h-xh-git/STM32-ESP32-MP3-Player/docs/images/esp32s3-pinout.png

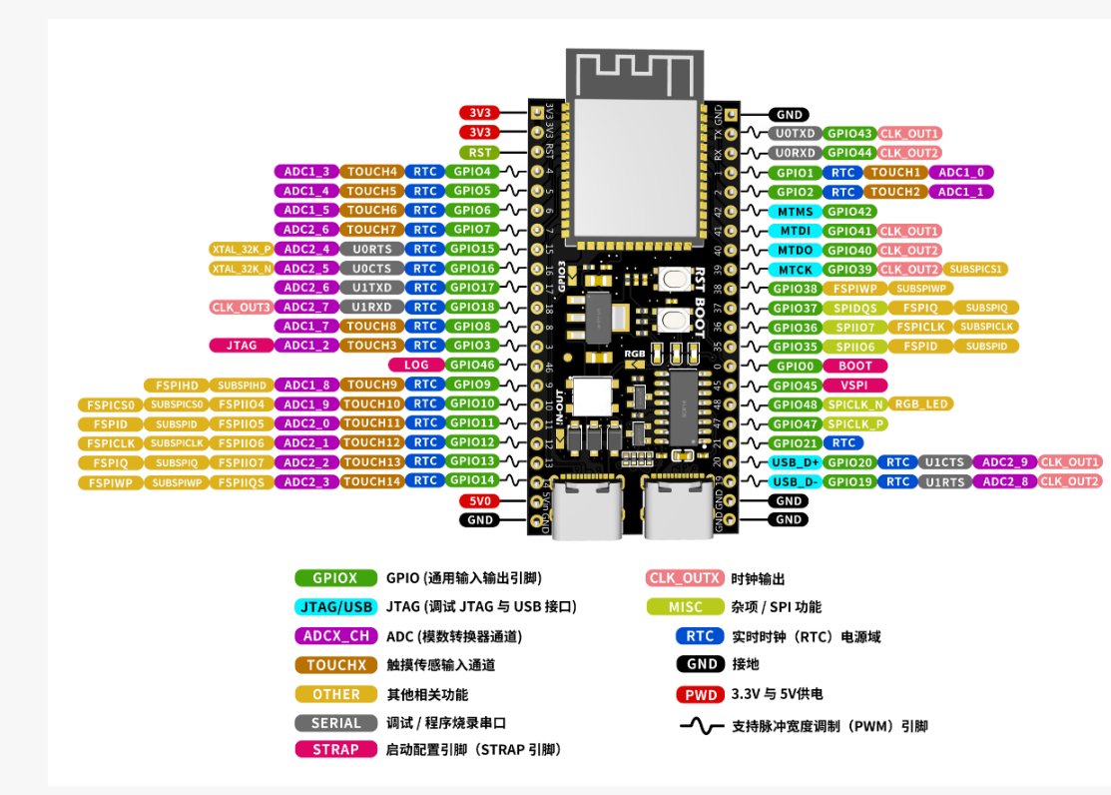
docs/images/esp32s3-pinout.png
