h-xh-git/STM32-ESP32-MP3-Player/docs/roadmap.md

# 基于 STM32F407 与 ESP32-S3 的双板 MP3 音乐播放器
# 最优项目开发规划书 (v2.0)

> **历史文档提示**：本文是开发初期的规划书，保留原样以记录当时的决策过程。
> 最终实现与验收以仓库根 [README.md](../README.md) 与 [docs/delivery-notes.md](delivery-notes.md) 为准 ——
> 例如 FatFS 码页最终采用 **437**（文中写的 936 是最初方案，为省 174 KB 转换表而改），GBK 歌词改由 `stm32/app/gbk2312_map.h` 提供。

> 编制依据：《基于STM32F407与ESP32-S3的双板MP3音乐播放器项目计划书》
> 补充依据：现有两套工程（STM32F407_ProjectTemplate 双板示波器 / esp32 WiFi Web Scope）代码勘察
> 硬件依据：立创天空星(LCKFB)官方 Wiki、ESP32-S3-WROOM-1 N16R8 引脚约束、MAX98357A 数据手册
> 版本说明：本版**完全放弃旧示波器工程的引脚约束**，按"最优"原则重新设计全部引脚。

---

## 0. 执行摘要

本规划书在四项前提已确认的基础上编制：

| 项目 | 已确认结论 |
|---|---|
| 硬件形态 | 立创天空星 STM32F407VET6 核心板 + 外接 ST7789 2.4寸 SPI 屏 + MAX98357A + 独立按键 |
| 存储 | 使用核心板**板载 TF 卡座**（SDIO 4-bit，硬连 PC8–PC12 / PD2） |
| 架构分工 | 保持计划书分工：STM32 管 SD+FATFS+UI+按键，ESP32-S3 管 MP3 软解 + I2S |
| 引脚 | 全部重新设计，见第 2 章（旧工程引脚一律不受限） |

**一句话方案**：STM32F407 用 SDIO 4 位 + FATFS 读取 TF 卡上的 MP3 压缩码流，经 USART2 @ 1 Mbps 按"信用窗口"协议推送给 ESP32-S3；ESP32-S3 在 8 MB OPI PSRAM 中建立 512 KB 播放缓冲，用 Helix 定点解码器解出 16 bit 立体声 PCM，经 I2S 送 MAX98357A 驱动 8Ω 喇叭；STM32 侧同步驱动 320×240 播放器界面与 5 个按键。

**关键量化指标**：

| 指标 | 设计值 | 说明 |
|---|---|---|
| 链路速率 | 1 Mbps（可升 2 Mbps） | USART2 挂 APB1 42 MHz，BRR=42 **分频误差 0** |
| 链路吞吐 | 约 95 KB/s | 320 kbps MP3 仅需 40 KB/s，余量 **2.4 倍** |
| 音频块 | 1024 B / 帧 | 帧开销 8 B，效率 99.2% |
| 播放缓冲 | 512 KB PSRAM | 目标水位 384 KB，实测水位应不低于 32 KB |
| 启动时延 | 上电 → 首声 ≤ 3 s | 含扫卡、填缓冲 64 KB |
| 按键响应 | UI ≤ 50 ms / 出声 ≤ 300 ms | 切歌 ≤ 500 ms |
| 连续播放 | 60 分钟零断音 | 验收项 AC3 |

---

## 1. 需求 → 现状差距矩阵

| 编号 | 计划书要求 | 现有工程状态 | 差距与处置 |
|---|---|---|---|
| G1 | SDIO 4 位 + FATFS 管理 TF 卡 | 无任何 FatFS 代码（检索命中 0） | 新增 BSP + 移植 FatFS R0.15 |
| G2 | 遍历目录生成 MP3 播放列表 | 无 | 新增 App/playlist |
| G3 | TFT 显示歌名/状态/序号 | 有 ST7789 驱动但为示波器布局 | 复用驱动，**重写界面层** |
| G4 | 按键播放/暂停/上下曲/音量± | 有 4 键扫描（PC0–PC3） | 复用逻辑，**改引脚为 PC0–PC4** |
| G5 | 串口双向通信 | 有 USART2 + AA55 帧协议（示波器语义） | **改波特率 460800→1 Mbps、改类型码、加流控** |
| G6 | ESP32 MP3 软件解码 | 无任何音频代码 | 新增 Helix 解码器 |
| G7 | I2S 数字音频输出 | 无 | 新增 I2S 驱动 + DMA |
| G8 | PSRAM 环形缓存 | 无（PSRAM 已配置可用） | 新增 512 KB PSRAM 缓冲 |
| G9 | 音量无级调节 | 无 | 新增 Q15 软件增益 |
| G10 | 无爆音、无卡顿 | 无音频链路 | 7 条反爆音设计（第 3.3 节） |
| G11 | 长中文文件名 + FAT32 稳定挂载 | 无 | FatFS 配 936 代码页 + LFN |
| G12 | 界面还原设计稿 | 无（设计稿为 HTML 原型） | 按 320×240 像素 1:1 还原 |

**可复用的既有资产**（详见附录 A）：时钟/延时、SysTick、ST7789 驱动、字库（14 px 中文）、按键消抖、UART 环形缓冲与中断框架、CRC 帧收发状态机、Keil 工程骨架、PlatformIO 工程骨架。

---

## 2. 硬件引脚设计（全新）

### 2.1 设计原则

1. **总线最优**：高速外设挂 APB2（SPI1 / USART1 / TIM8）；链路串口挂 APB1 但选分频可整除的引脚组。
2. **端口聚合**：同一功能集中在同一 GPIO 端口，便于 BSRR 原子写入与位带操作。
3. **独占 SDIO**：PC8–PC12 + PD2 六个脚被 SDIO 完全独占，其他功能一律让开。
4. **避开板载固定占用**：晶振（PC14/PC15）、USB（PA11/PA12）、SWD（PA13/PA14）、BOOT1/LED（PB2）、板载用户键（PA0）、SWO（PB3）。
5. **每项留 Plan B**：焊接或飞线异常时可平行替换（见 2.7）。
6. **预留 P2 扩展**：编码器、蜂鸣器占脚但**不占用关键资源**，P1 可不焊。

### 2.2 STM32F407VET6（天空星）引脚总表

| 功能块 | 信号 | 引脚 | 复用方式 | 方向 | 设计说明 |
|---|---|---|---|---|---|
| SDIO | SDIO_CK | **PC12** | AF12 | O | 板载 TF 卡座，独占 |
| | SDIO_CMD | **PD2** | AF12 | IO | |
| | SDIO_D0 | **PC8** | AF12 | IO | |
| | SDIO_D1 | **PC9** | AF12 | IO | |
| | SDIO_D2 | **PC10** | AF12 | IO | |
| | SDIO_D3 | **PC11** | AF12 | IO | |
| | TF_DET | **PD3** | 输入上拉 | I | 插卡为低电平 |
| TFT | LCD_SCK | **PA5** | SPI1 AF5 | O | 21 MHz（APB2 84 M ÷ 4） |
| | LCD_MOSI | **PA7** | SPI1 AF5 | O | 只写，不用 MISO |
| | LCD_CS | **PA4** | GPIO 推挽 | O | |
| | LCD_DC | **PB0** | GPIO 推挽 | O | |
| | LCD_RST | **PB1** | GPIO 推挽 | O | |
| | LCD_BLK | **PB10** | TIM2_CH3 AF1 | O | PWM 10 kHz 背光调光 |
| 按键 | KEY_PLAY | **PC0** | 输入上拉 | I | 低有效 |
| | KEY_PREV | **PC1** | 输入上拉 | I | |
| | KEY_NEXT | **PC2** | 输入上拉 | I | |
| | KEY_VOL_UP | **PC3** | 输入上拉 | I | |
| | KEY_VOL_DN | **PC4** | 输入上拉 | I | |
| 链路 | LINK_TX | **PA2** | USART2 AF7 | O | → ESP32 GPIO17 |
| | LINK_RX | **PA3** | USART2 AF7 | I | ← ESP32 GPIO18 |
| 调试 | DBG_TX | **PA9** | USART1 AF7 | O | 接 2×5P 调试排针 |
| | DBG_RX | **PA10** | USART1 AF7 | I | 115200 日志口 |
| P2 | BEEP | **PB8** | TIM4_CH3 AF2 | O | 可选无源蜂鸣器 |
| P2 | ENC_A | **PC6** | TIM8_CH1 AF3 | I | 可选旋转编码器 |
| P2 | ENC_B | **PC7** | TIM8_CH2 AF3 | I | |
| P2 | ENC_SW | **PC5** | 输入上拉 | I | |

**占用 26 脚（P1）+ 4 脚（P2）**，F407VE LQFP100 共 82 个可用 IO，余量充足。

**必须保留、禁止挪用的引脚**：

| 引脚 | 板载用途 | 说明 |
|---|---|---|
| PA0 | 用户按键 KEY1 | 板载按钮 |
| PA11 / PA12 | Type-C USB D− / D+ | 板载 |
| PA13 / PA14 | SWDIO / SWCLK | 下载调试，绝不可占 |
| PB2 | BOOT1 + 板载 LED | **上电时被下拉，启动期间不得输出高** |
| PB3 | SWO | 调试排针 |
| PC13 / PC14 / PC15 | 32.768 kHz 低速晶振焊盘 | 青春版未贴装，仍建议避开 |
| BOOT0 | 启动选择 | 板载按钮 |

**端口聚合收益举例**：5 个按键全在 GPIOC 的 PC0–PC4。一次读取 GPIOC->IDR 与掩码 0x1F 即取回全部键态；消抖只需保存一个 5 bit 历史值，无需逐脚读取。

### 2.3 ESP32-S3-WROOM-1 N16R8 引脚总表

**禁区（不可用）**：

| 区间 | 原因 |
|---|---|
| GPIO26 – GPIO37 | SPI Flash（26–32）与 **OPI PSRAM（33–37）** 占用 |
| GPIO19 / GPIO20 | 原生 USB D− / D+ |
| GPIO43 / GPIO44 | UART0（板载 CH340 日志与烧录口，必须保留） |
| GPIO0 / GPIO3 / GPIO45 / GPIO46 | Strapping 启动配置脚 |

**可用**：GPIO1、2、4–18、21、38–42、47、48。

**本方案分配**：

| 功能 | GPIO | 方向 | 说明 |
|---|---|---|---|
| LINK_RX | **GPIO17** | I | ← STM32 PA2 |
| LINK_TX | **GPIO18** | O | → STM32 PA3 |
| I2S_BCLK | **GPIO5** | O | → MAX98357A BCLK |
| I2S_LRC | **GPIO6** | O | → MAX98357A LRC |
| I2S_DIN | **GPIO7** | O | → MAX98357A DIN |
| AMP_SD | ~~GPIO8~~ **不用** | — | **最终接线：MAX98357A SD/MODE 直接接 3V3**（实测 560 kΩ 方案沙沙/发闷/人声小，见 3.2.1）；固件用 -DPIN_AMP_SD=-1 |
| LED_STATUS | **GPIO48** | O | 板载 WS2812 状态指示（可选） |
| 保留 | GPIO1 / GPIO2 | — | P2 扩展备用 |
| 保留 | GPIO43 / GPIO44 | — | UART0 调试与烧录 |

选择 GPIO5/6/7 的理由：均为自由脚、互不冲突、与 17/18 分开便于走线；ESP32-S3 的 I2S 可经 GPIO 矩阵映射到任意空闲脚，不存在"必须用某脚"的限制。

### 2.4 板间连线表（最终接线）

| # | STM32 天空星 | ESP32-S3 | MAX98357A | 说明 |
|---|---|---|---|---|
| 1 | PA2 (LINK_TX) | GPIO17 | — | 串口数据 |
| 2 | PA3 (LINK_RX) | GPIO18 | — | 串口数据 |
| 3 | GND | GND | GND | **必须共地** |
| 4 | — | GPIO5 | BCLK | 位时钟 |
| 5 | — | GPIO6 | LRC | 左右声道时钟 |
| 6 | — | GPIO7 | DIN | 音频数据 |
| 7 | — | — | SD/MODE 直接接 3V3 | 常开（只出左声道；固件已下混单声道）；560 kΩ 方案实测沙沙，见 3.2.1 |
| 8 | — | 5V | VIN | 功放供电 5 V |
| 9 | — | — | OUT+ → 喇叭 + | 差分输出 |
| 10 | — | — | OUT− → 喇叭 − | **严禁接地** |
| 11 | — | — | GAIN 悬空 | 默认 9 dB 增益 |

**电源方案**：推荐 5 V / 2 A 单电源适配器分三路供电——STM32 核心板一路、ESP32-S3 一路、MAX98357A 一路。功放峰值电流可达 650 mA，务必给足不低于 800 mA 的余量；VIN–GND 就近并 **470 µF 电解 + 0.1 µF 陶瓷**。

**接地（防爆音关键）**：星形单点接地。功放地线**单独走**到电源入口，**不要**串到 MCU 的地线路径上，否则 D 类功放的大电流纹波会耦合进 MCU 地平面造成干扰。

### 2.5 时钟与总线预算

| 外设 | 挂载总线 | 总线频率 | 配置速率 | 备注 |
|---|---|---|---|---|
| SDIO | PLL48CK | 48 MHz | 24 MHz（CLKDIV=0） | 识别阶段不高于 400 kHz |
| SPI1 | APB2 | 84 MHz | 21 MHz（÷4） | 屏显，可降 ÷8 = 10.5 MHz |
| USART2 | APB1 | 42 MHz | 1 Mbps（BRR=42，误差 0） | 可升 2 Mbps（BRR=21，误差 0） |
| USART1 | APB2 | 84 MHz | 115200 | 日志 |
| TIM2 (背光) | APB1×2 | 84 MHz | PSC=83, ARR=99 → 10 kHz | 5 档亮度 |
| TIM4 (蜂鸣) | APB1×2 | 84 MHz | P2 | |

### 2.6 引脚冲突自查

| 检查项 | 结论 |
|---|---|
| SDIO 六脚是否被其他功能占用 | 无。PC8–PC12/PD2 全部只用于 SDIO |
| SPI1 与 USART2 是否共享引脚 | 无。PA5/PA7 与 PA2/PA3 互不重叠 |
| 按键与 SDIO 是否冲突 | 无。按键用 PC0–PC4，SDIO 从 PC8 起 |
| 调试口是否被占 | 无。PA13/PA14/PB3/PA9/PA10 全部保留 |
| ESP32 I2S 与链路是否冲突 | 无。GPIO5/6/7 与 17/18 分离 |
| ESP32 是否误用禁区脚 | 无。全部落在 GPIO1/2/4–18/21/38–42/47/48 内 |

### 2.7 待实测确认项与 Plan B

**待实测（阶段 0 首日完成）**：

| # | 待确认项 | 影响 | 若不符合的处置 |
|---|---|---|---|
| 1 | 天空星青春版排针是否已焊接；PC8–PC12、PD2、PD3、PA2–PA7、PB0/PB1/PB10、PC0–PC4 是否引出 | 全部接线 | 自行焊排针或启用 Plan B |
| 2 | PD3 是否确为核心板 TF 插入检测（低有效） | 插拔卡识别 | 改用软件定时探测或空置 |
| 3 | MAX98357A 模块 SD 脚是否自带 1 MΩ 上拉（Adafruit 款） | 静音与声道 | 断开该电阻，按 3.2 节接 560 kΩ |

**Plan B 引脚替代方案**：

| 功能 | 首选 | 备选 |
|---|---|---|
| LCD_BLK | PB10 (TIM2_CH3) | PB8 (TIM4_CH3) 或直接接 3.3 V 放弃调光 |
| KEY 五键 | PC0–PC4 | PD0/PD1/PD4/PD5/PD6（避开 PD2） |
| LINK 串口 | PA2/PA3 (USART2) | PD5/PD6 (USART2 重映射) 或 PB10/PB11 (USART3) |
| LCD SPI | PA5/PA7 (SPI1) | PB3/PB5 (SPI1 重映射，需禁用 JTAG) |
| 编码器 (P2) | PC5/PC6/PC7 | PD12/PD13/PC13 |

---

## 3. MAX98357A 音频输出设计

### 3.1 引脚判据（已核实）

**GAIN 引脚（决定增益，改动后需重新上电）**：

| 增益 | 接法 |
|---|---|
| 15 dB | 100 kΩ 电阻接 GND |
| 12 dB | GAIN 直接接 GND |
| **9 dB** | **悬空（默认，本方案采用）** |
| 6 dB | GAIN 直接接 Vin |
| 3 dB | 100 kΩ 电阻接 Vin |

**SD / MODE 引脚（三态，同时决定关断与输出声道）**：

| SD 电压 | 行为 |
|---|---|
| 低于 0.16 V | **关断（硬件静音）** |
| 0.16 V – 0.77 V | 输出 **(L + R) / 2**，立体声平均值 |
| 0.77 V – 1.4 V | 只输出右声道 |
| 高于 1.4 V | 只输出左声道 |

**关键细节**：SD 脚内部有 **100 kΩ 下拉**。Adafruit 官方模块另在 SD 与 Vin 之间加了 1 MΩ 上拉，使其在 5 V 供电时默认落在"立体声平均"区。

### 3.2 推荐电路（同时获得硬件静音 + 真单声道混合）

| 参数 | 取值 |
|---|---|
| AMP_SD 驱动脚 | ESP32 GPIO8 |
| 串联电阻 | **560 kΩ**（GPIO8 → SD 节点） |
| SD 节点对地 | 模块内部 100 kΩ 下拉 |
| GPIO8 输出高 (3.3 V) | SD ≈ 3.3 × 100 / (100 + 560) = **0.50 V** → 落在 0.16–0.77 V → **(L+R)/2 单声道混合** |
| GPIO8 输出低 (0 V) | SD ≈ 0 V → **关断静音** |

**收益**：用一个 GPIO 同时实现①上电/切歌/暂停的硬件级静音（反爆音最有效的手段）②立体声下混为单声道，避免"只出左声道丢失右声道信息"。

**注意事项**：
- 若使用 Adafruit 款模块（SD–Vin 间自带 1 MΩ），必须**先断开该 1 MΩ**，否则电平被抬到不低于 0.77 V 变成只出右声道。
- ESP32 上电/复位期间 GPIO8 为高阻，此时 SD 电平不确定——因此**必须在固件最早阶段把 GPIO8 配置为推挽输出低**（早于 I2S 初始化）。
- 若模块无法改造，退路是 SD 直接接 Vin（只出左声道），或用 3 脚跳线手动选择。

#### 3.2.1 实机实测结论与最终接线（以此为准）

按 3.2 节的 560 kΩ 方案实机接线后，喇叭**全程沙沙、发闷、人声小**；把 SD 直接接 3V3 后沙沙消失，只剩"大音量/强高音破音"。结合数据手册，最可能的解释是**560 kΩ 方案在本模块上没落在设计假设的 0.50 V，而是停在声道模式分界线上**：

| 计算（前提：该模块带 Adafruit 款 1 MΩ 上拉且未断开） | 数值 |
|---|---|
| SD 节点 = (3.3/560 + 5/1000) / (1/560 + 1/1000 + 1/100) | **≈ 0.85 V** |
| 该电压所属档位 | **0.77 – 1.4 V = 只出右声道，且紧贴 0.77 V 分界线** |

⇒ 任何耦合噪声都会让功放在“(L+R)/2”与“只出右声道”之间来回跳，听感就是**随音量变化的沙沙 + 发闷 + 人声小**（信号相关失真）；这也解释了“暂停时没有沙沙”（无信号就没有可失真的内容）。

**最终采用接线（本机实测通过）：**

| 项 | 取值 | 说明 |
|---|---|---|
| MAX98357A SD/MODE | **直接接 3V3** | 电压 > 1.4 V ⇒ 功放常开、只输出左声道；节点低阻，不会被噪声推着跳档 |
| ESP32 GPIO8 | **不用**（固件 -DPIN_AMP_SD=-1） | 不再驱动该脚；静音改由播放器内部淡出 + 输出全 0 帧承担 |
| GAIN | **悬空**（9 dB） | 实测值；若大音量仍破音，改成 **3 dB 档：GAIN 经 100 kΩ 接 Vin**（多 6 dB 余量）。注意官方增益表是"经 100 kΩ 接 GND = 15 dB、直接接 GND = 12 dB"，**把 GAIN 直接接 GND 会更响更破，别接错** |
| 声道处理 | **固件把 (L+R)/2 下混成单声道并复制到左右两槽** | SD 落哪一档都输出同一份完整混音 ⇒ “只出左声道”不丢内容（player.cpp 写 I2S 前） |
| 峰值余量 | **固件软限幅到 −6 dBFS** | 大音量/强高音不再硬削波（player.cpp 音量缩放之后） |

取舍：放弃“GPIO 硬件静音”换来稳定的声道模式；第 3.3 节的时钟不停、淡入淡出、欠载保护、去耦等措施继续生效。若日后一定要恢复硬件静音，正确做法是让 SD 稳定停在中间档（例如 **SD 经 1 MΩ 上拉到 3.3 V**，配内部 100 kΩ 下拉 ≈ 0.30 V，落在 0.16–0.77 V），而不是经 560 kΩ 接一个 3.3 V 的 GPIO（本机实测失败）。

### 3.3 七条反爆音措施（验收项 AC7 的保障）

1. **上电静音**：上电第一时间 GPIO8 = 低（功放关断），直到 I2S 就绪且缓冲预填不低于 64 KB 才拉高。
2. **I2S 时钟不停**：空闲时 DMA 持续输出全 0 数据。BCLK 停止会使 MAX98357A 进入异常状态并在恢复时爆音。
3. **淡入淡出**：每次播放/暂停/恢复/切歌，对 PCM 首尾各 **20 ms** 做线性斜坡。
4. **欠载保护**：缓冲水位低于 32 KB 时先淡出再输出静音帧，恢复时淡入。
5. **停止顺序**：先淡出 → 关功放（GPIO8 低）→ 停 I2S DMA。**顺序不可颠倒**。
6. **电源去耦**：VIN 就近 470 µF + 0.1 µF，功放地独立走线，星形单点接地。
7. **切歌去爆**：切歌必须先停流、清缓冲、重新定位后淡入，不允许在解码中途直接替换数据。

---

## 4. 系统架构与关键设计决策

### 4.1 分层与数据流

```
按键 / UI (STM32)
   |
   v
player.c 播放状态机 (STM32)
   |  CMD_* 控制指令  -->  USART2 1 Mbps  -->  ESP32 link_task
   |                                              |
   |                                         流控窗口决策
   |  <-- CMD_AUDIO_REQ {blocks} -----------------+
   v
audio_srv.c 非阻塞 SDIO-DMA 读取
   |  f_read 1024 B
   |  RESP_AUDIO {seq, len, data}
   +--> USART2 TX 环形缓冲 --> ESP32 512 KB PSRAM 环形缓冲
                                    |
                               Helix MP3 解码
                                    |  16 bit 立体声 PCM
                               I2S DMA --> MAX98357A --> 8 欧姆喇叭
```

### 4.2 关键设计决策表

| 编号 | 决策 | 理由 |
|---|---|---|
| D1 | **链路传 MP3 压缩码流，绝不传 PCM** | 320 kbps MP3 约 40 KB/s；解码后 PCM = 44.1k×16×2 = 176 KB/s，串口不可能承载 |
| D2 | **波特率定为 1 Mbps** | USART2 挂 APB1 42 MHz，BRR = 42 **整除、误差 0**；有效吞吐约 95 KB/s，对 40 KB/s 需求余量 2.4 倍。460800 仅 46 KB/s，余量不足必然爆音 |
| D3 | **保留 2 Mbps 升级路径** | BRR = 21 同样整除误差 0；仅在 1 Mbps 实测误码率不达标时才启用 |
| D4 | **ESP32 主动拉取（pull）流控** | STM32 只在收到请求后才发送，**构造上不可能溢出** ESP32 接收缓冲；无需 ACK、无需重传 |
| D5 | **信用窗口算法** | win = clamp((目标水位 − 当前水位) / 块大小, 0, 64)；在途未完成请求数小于 win 时补发请求。水位高时自动停发，水位低时自动加速，无需人工调参 |
| D6 | **帧协议沿用 AA55 同步头，CRC-8 升级为 CRC-16/CCITT-FALSE** | 1024 B 长帧下 CRC-8 漏检率过高（1/256）；CRC-16/CCITT-FALSE 漏检率约为 1/65536，成本仅多 1 字节 |
| D7 | **STM32 侧用非阻塞状态机 + SDIO DMA + ping-pong 双缓冲** | 旧工程注释已记录教训："主循环里不能有阻塞操作"。SDIO 读 1 KB 若阻塞可达 1 ms 以上，会拖慢 UI 与链路 |
| D8 | **ESP32 侧用 FreeRTOS 多任务** | Arduino 框架已含 FreeRTOS；link/dec 两任务解耦，解码阻塞不影响收帧。N16R8 有 8 MB PSRAM 与 512 KB SRAM，资源充裕 |
| D9 | **解码器选 Helix MP3** | 定点运算、内存占用小、单文件易移植、无外部依赖；ESP-ADF 需把工程从 Arduino 改为 ESP-IDF，改动过大；libmad 内存占用高 |
| D10 | **输出统一 44.1/48 kHz、16 bit、立体声** | 与计划书一致；采样率由 MP3 帧头自适应；单声道下混由 MAX98357A 硬件完成（见 3.2） |
| D11 | **音频块 1024 B** | 帧总长 1032 B，@1 Mbps 用时 10.3 ms，链路占空比 41%；块再大会增加延迟与缓冲压力，再小则开销上升 |
| D12 | **环形缓冲尺寸** | STM32：TX 4096 B、RX 1024 B；ESP32：RX 8192 B、播放缓冲 512 KB。旧工程 TX 只有 2048 B 且发送函数在空间不足时整帧丢弃，必须扩 |
| D13 | **范围控制：P1 不做歌词与真实封面** | 滚动歌词需 .lrc 解析、真实封面需 JPEG 解码器，均属额外子系统。设计稿中的封面区域 P1 用图标占位 |

---

## 5. 板间通信协议规范

### 5.1 帧格式

```
+--------+--------+--------+--------+--------+---------+---------+--------+
| 0xAA   | 0x55   | TYPE   | LEN_LO | LEN_HI | PAYLOAD | CRC_LO  | CRC_HI |
+--------+--------+--------+--------+--------+---------+---------+--------+
  同步头(2B)          类型(1B)  长度(2B,小端)   载荷(N)   CRC16(2B,小端)
```

- **CRC-16/CCITT-FALSE**：多项式 0x1021，初值 0xFFFF，输入输出不反转，结果不异或。校验范围 = TYPE + LEN_LO + LEN_HI + PAYLOAD。
- **最大载荷**：1024 B（音频块）。协议层接收缓冲按 1032 B 设计。
- **字节序**：小端。
- **重同步**：接收端在字节流中扫描 0xAA 0x55；帧内出现 0xAA55 不影响，因为变长帧必须 CRC 校验通过才被接受，否则整帧丢弃并继续扫描。

### 5.2 类型码表

**ESP32 → STM32（0x1x，请求/命令）**

| 类型码 | 名称 | 载荷 | 说明 |
|---|---|---|---|
| 0x10 | CMD_PLAY | track:u16 | 播放第 track 首 |
| 0x11 | CMD_PAUSE | — | 暂停 |
| 0x12 | CMD_RESUME | — | 恢复 |
| 0x13 | CMD_NEXT | — | 下一曲 |
| 0x14 | CMD_PREV | — | 上一曲 |
| 0x15 | CMD_STOP | — | 停止 |
| 0x16 | CMD_VOL | vol:u8 | 音量 0–100 |
| 0x17 | CMD_MODE | mode:u8 | 0 列表循环 / 1 单曲循环 / 2 随机 |
| 0x18 | CMD_SEEK | ms:u32 | 定位（P2） |
| 0x19 | **CMD_AUDIO_REQ** | blocks:u16 | **信用请求：再给 blocks 块** |
| 0x1A | CMD_LIST_REQ | from:u16, count:u16 | 请求曲目列表分页 |
| 0x1B | CMD_PING | tick:u32 | 心跳 |
| 0x1C | **CMD_SYNC_POS** | track:u16, offset:u32, seq:u32 | **重同步：定位到流内偏移并重置序号** |

**STM32 → ESP32（0x2x，应答/数据）**

| 类型码 | 名称 | 载荷 | 说明 |
|---|---|---|---|
| 0x20 | **RESP_AUDIO** | seq:u32, len:u16, data[len] | **音频数据块** |
| 0x21 | RESP_STATE | track:u16, total:u16, state:u8, vol:u8, mode:u8 | 播放状态 |
| 0x22 | RESP_TIME | ms:u32, total_ms:u32 | 进度与总时长 |
| 0x23 | RESP_LIST | index:u16, total:u16, name[64] | 曲目列表项 |
| 0x24 | RESP_END | track:u16, reason:u8 | 流结束（自动切歌） |
| 0x25 | RESP_PONG | tick:u32, drops:u16 | 心跳应答 |
| 0x26 | RESP_ACK | cmd:u8, status:u8 | 命令应答 |

### 5.3 信用窗口流控（核心机制）

**ESP32 侧状态**：fill（缓冲已填字节）、cap = 512 KB、target = 384 KB、inflight（已发出但未收到的块数）。

**每轮循环执行**：

```
win = clamp((target - fill) / 1024, 0, 64)
if (inflight < win) {
    blocks = min(win - inflight, 16)
    send CMD_AUDIO_REQ { blocks }
    inflight += blocks
}
```

**STM32 侧状态**：pending（待发送块数）、next_seq。

```
收到 CMD_AUDIO_REQ:  pending += blocks

状态机循环:
    while (pending > 0 && TX 环形缓冲空间足够) {
        从 SD 读 1024 B  ->  组 RESP_AUDIO { seq = next_seq++, len, data }
        pending--
    }
```

**性质**：
- ESP32 缓冲接近满时 win 归 0，自动停止请求，**不需要任何人工限速**。
- 缓冲为空时 win = 64，链路立刻满速填充，**启动快**。
- 因为 STM32 严格按请求发送，**接收端永远不会溢出**，从根上消除丢包。

### 5.4 错误恢复

| 故障 | 检测方式 | 处置 |
|---|---|---|
| CRC 校验失败 | 帧尾 CRC 不匹配 | 丢弃该帧，继续扫描 0xAA55 重新同步 |
| 音频块序号空洞 | resp.seq 不等于 expected_seq | ESP32 停止解码、清空缓冲、发 CMD_SYNC_POS{track, offset = 已消耗字节偏移, seq} 重开流 |
| 链路静默 | STM32 侧 2 s 无任何请求 | 停止读卡，进入 IDLE，UI 显示"音频模块未连接" |
| 链路静默 | ESP32 侧 1 s 无数据 | 重发 CMD_PING，连续 3 次无应答则复位链路状态 |
| 对端未上电 | 上电握手 | STM32 独立运行完整 UI/按键/列表功能，只是无声 |

---

## 6. 存储与播放列表（STM32）

### 6.1 FatFS 配置

| 配置项 | 取值 | 理由 |
|---|---|---|
| _FS_TINY | 1 | 减小 FIL 结构，省 RAM |
| _USE_LFN | 3 | 静态 LFN 缓冲，避免占用栈 |
| _CODE_PAGE | 936 | 简体中文 GBK，与字库编码一致 |
| _VOLUMES | 1 | 只用 SD 卡 |
| _MAX_SS | 512 | 不带 4 KB 扇区卡 |
| _USE_MKFS / _USE_LABEL | 0 | 不需要 |
| _FS_REENTRANT | 0 | 单任务访问 FatFS，无需加锁 |

**必须一致**：FatFS 代码页 936 与 TFT 字库编码必须同为 GBK，否则全部中文名显示为乱码。这是最容易被忽略的一致性问题。

### 6.2 目录扫描

- 优先扫描 /MUSIC 目录；不存在则扫描根目录。
- 匹配 .mp3（大小写不敏感）；跳过子目录、隐藏文件、0 字节文件。
- 上限 300 首；每首存 64 B 文件名 + 4 B 大小。
- **自然排序**：文件名中的数字段按数值比较，保证 01、02、…、10 顺序正确（纯字典序会把 10 排在 2 之前）。
- 超长文件名截断并追加省略号。
- 坏文件（打开失败、ID3 头异常大）跳过并记入错误计数。

### 6.3 SDIO 非阻塞读取（关键实现）

```
状态机: IDLE -> DMA_ISSUED -> WAIT_DONE -> SEND -> IDLE

IDLE        : pending > 0 且有空闲块缓冲 -> 配置 SDIO DMA，
              发起 SDIO_ReadMultiBlocks(2 扇区)，立即返回不等待
DMA_ISSUED  : 主循环继续跑 UI / 按键 / 协议
WAIT_DONE   : 下一个 1 ms 节拍检查 DMA 完成标志与 SDIO_FLAG_DBCKEND
SEND        : 把完成的块组帧写入 USART2 TX 环形缓冲，释放该块
```

- **ping-pong 双缓冲**：一块在从 SD 读取时，另一块在等待/发送，吞吐翻倍。
- **每块 2 扇区（1 KB）**：SDIO @24 MHz 下理论 341 µs 加卡访问延迟，典型小于 1 ms。
- **降级路径**：T1 阶段可先用阻塞式 f_read 打通功能，T2 阶段再替换为非阻塞状态机。功能与性能解耦，降低风险。

---

## 7. 界面与显示优化（STM32）

### 7.1 布局（按 HTML 设计稿 320×240 横版 1:1 还原）

| 区域 | 位置 | 高度 | 内容 |
|---|---|---|---|
| 状态栏 | 顶部 | 22 px | 播放/暂停图标、歌名居中、播放模式、音量、SD 状态 |
| 侧边音量条 | 左 | 24 px 宽 | 操作时显示，1.5 s 后自动隐藏 |
| 封面 | 左中 | 144×144 | **P1：图标占位；P2：真实封面** |
| 信息区 | 右中 | — | 标题（14 px 粗体）、歌手/序号、**歌词框（P2）**、进度条、时间 |
| 控制栏 | 底部 | 48 px | 音量减、上一曲、播放/暂停、下一曲、音量加、模式、歌单 |
| 歌单浮层 | 全屏 | — | 头部路径 + 曲目列表（每行 26 px） |

**配色（与设计稿 CSS 变量一致）**：背景 #0B0E14、面板 #151A23、卡片 #1C2333、边框 #263045、主文字 #E8EDF4、次文字 #7A8BA6、主色 #4FC3F7、强调 #FFD54F、成功 #66BB6A。

### 7.2 三级脏标志（沿用旧工程已验证的优化）

旧工程主程序 app/main.c 中已记录教训："不要无条件置 s_ui_dirty，否则每帧重画 320×150 画布（约 48000 像素 SPI）会有可见卡顿"。本方案沿用并推广：

| 标志 | 触发内容 | 重绘区域 |
|---|---|---|
| s_ui_dirty | 切歌、状态变化 | 状态栏 + 信息区 |
| s_progress_dirty | 每 250 ms | 进度条 约 200×6 px |
| s_time_dirty | 每秒 | 时间文字 约 110×16 px |

**效果**：静态界面 0 次重绘；播放中每秒 SPI 传输量约 5.9 KB/s，远低于 SPI1 @21 MHz 的 2.6 MB/s 能力，CPU 占用低于 1%。

### 7.3 其他显示优化

- **行缓冲**：uint16_t linebuf[LCD_W]（640 B），逐行生成后用 SPI1 DMA 发送，不阻塞 CPU。
- **字库**：14 px 中文 1 bpp，ASCII 加 GBK 子集；缺字显示方框占位。
- **背光 PWM**：TIM2_CH3 @10 kHz，5 档亮度，兼顾省电与体验。
- **歌单分页**：列表滚轮只重画变化的两行，不整屏刷新。

---

## 8. 音频子系统（ESP32-S3）

### 8.1 任务划分（FreeRTOS）

| 任务 | 优先级 | 职责 |
|---|---|---|
| link_task | 5 | 串口收帧、协议解析、流控窗口决策、命令分发 |
| dec_task | 4 | 从 PSRAM 缓冲取码流，Helix 解码，音量，淡入淡出，写 I2S |
| net_task | 2（P2） | WiFi / Web 控制 |
| loop() | 1 | Arduino 默认任务：状态灯、调试输出 |

单生产者（link_task 写缓冲）单消费者（dec_task 读缓冲），用一把互斥锁保护读写指针，避免优先级反转。

### 8.2 缓冲与内存

| 对象 | 大小 | 分配方式 |
|---|---|---|
| 播放环形缓冲 | 512 KB | PSRAM，heap_caps_malloc(MALLOC_CAP_SPIRAM) |
| 串口 RX 缓冲 | 8192 B | Serial1.setRxBufferSize |
| 解码输入工作区 | 4 KB | 内部 SRAM |
| 解码输出 PCM | 4608 B（1152 采样 × 2ch × 2B） | 内部 SRAM |
| I2S DMA | 6 × 256 帧 | 驱动内部 |

**注意**：N16R8 的 PSRAM 必须在 platformio.ini 中保持 qio_opi 加 -DBOARD_HAS_PSRAM，否则 PSRAM 不可用、512 KB 分配失败。

### 8.3 关键实现点

- **采样率自适应**：读取 MP3 帧头得到采样率（32/44.1/48 kHz），动态重配 I2S。
- **音量**：0–100 映射为 Q15 增益，解码输出后逐采样相乘，无级可调。
- **欠载保护**：fill 低于 32 KB 时输出静音并淡出，恢复时淡入，同时 underrun 计数上报。
- **EOF**：RESP_END 或缓冲耗尽则按播放模式自动切下一曲。
- **上电顺序**：GPIO8 低（静音）→ I2S 初始化并持续输出 0 帧 → 预填缓冲不低于 64 KB → GPIO8 高（开启功放）。
- **日志口**：务必使用板载 CH340 的 USB-C 口（UART0，COM8，115200）。项目原有 platformio.ini 注释已警告：**不要**添加 build_unflags = -DARDUINO_USB_MODE=1，也不要定义 ARDUINO_USB_MODE=0 / ARDUINO_USB_CDC_ON_BOOT=1，否则会切到原生 USB 而 CH340 口看不到日志。

---

## 9. 软件工程结构

### 9.1 STM32（Keil MDK5）

```
STM32_MP3/
├─ App/
│   ├─ app_main.c       主循环调度（1 ms 节拍）
│   ├─ playlist.c/h     目录扫描、自然排序、索引
│   ├─ player.c/h       播放状态机（播放/暂停/上下曲/模式）
│   ├─ audio_srv.c/h    ★ 非阻塞 SDIO-DMA 读取 + 组帧发送
│   └─ ui_player.c/h    ★ 播放器界面 + 三级脏标志
├─ BSP/
│   ├─ board/           时钟、SysTick、延时（可直接复用）
│   ├─ bsp_sdio/        ★ SDIO 4-bit 驱动 + DMA
│   ├─ bsp_lcd/         ST7789 驱动（复用 + 改引脚）
│   ├─ bsp_ui/          文本/图形原语 + 字库（复用，重写布局）
│   ├─ bsp_key/         5 键扫描消抖（复用 + 改引脚）
│   ├─ bsp_backlight/   ★ TIM2_CH3 PWM 背光
│   ├─ bsp_uart_link/   ★ USART2 1 Mbps + 环形缓冲（改自 bsp_uart2）
│   └─ bsp_proto/       ★ 帧协议 + CRC-16 + 收状态机（升级自 bsp_proto）
├─ FatFS/               ★ ff.c / ff.h / ffconf.h / diskio.c
├─ Core/                main.c / stm32f4xx_it.c
├─ module/stm32f4xx_conf.h   （需 include stm32f4xx_sdio.h）
├─ libraries/           CMSIS + STM32F4xx_StdPeriph_Driver
└─ project/MDK(V5)/     Keil 工程
```

**删除**：bsp/adc、bsp/scope、bsp/oled（含 44337 B 字库）、bsp/buzzer、bsp/encoder（移到 P2）。

### 9.2 ESP32-S3（PlatformIO / Arduino）

```
esp32_mp3/
├─ platformio.ini       保持 espressif32@6.9.0 + qio_opi + 16MB + opi PSRAM
├─ src/main.cpp         任务创建与调度
└─ lib/
    ├─ link/            ★ 串口收发 + 环形缓冲
    ├─ proto/           ★ 帧编解码 + CRC-16
    ├─ player/          ★ PSRAM 环形缓冲 + 流控窗口 + 播放状态
    ├─ mp3/             ★ Helix 解码器封装
    ├─ audio_out/       ★ I2S + 音量 + 淡入淡出 + AMP_SD 控制
    └─ net/             P2: WiFi / Web（基于现有 osc_wifi/osc_web 改造）
```

**删除**：lib/osc_link、lib/osc_proto（协议语义完全改变）；lib/osc_wifi、lib/osc_web 保留为 P2 基础。

---

## 10. 工作分解结构（WBS）与排期

总工期 **19 个工作日 + 2 天缓冲 = 21 天**（与计划书一致）。

### 阶段 0：硬件定案与环境（1 天）

| 任务 | 内容 | 产出 |
|---|---|---|
| T0.1 | 天空星核心板排针焊接状态核查；逐一实测 PC8–PC12、PD2、PD3、PA2–PA7、PB0/PB1/PB10、PC0–PC4 是否引出 | 引脚可用性确认单 |
| T0.2 | 焊接排针；TFT、按键、MAX98357A、喇叭按 2.4 接线表连接 | 可上电的硬件平台 |
| T0.3 | 裁剪 Keil 工程 + 新建 PlatformIO 工程；两板各自点灯、1 Mbps 串口回环 | **M0：两板可烧录、可互发数据** |

### 阶段 1：STM32 存储与界面（5 天）

| 任务 | 内容 |
|---|---|
| T1.1 | SDIO 4-bit 驱动（识别 + 24 MHz 工作时钟 + DMA） |
| T1.2 | **FatFS 移植（936 代码页、长中文名）** ★关键路径 |
| T1.3 | **目录扫描 + 播放列表 + 自然排序** ★关键路径 |
| T1.4 | ST7789 驱动（行缓冲 + SPI1 DMA + 背光 PWM） |
| T1.5 | 播放器界面（按设计稿，三级脏标志） |
| T1.6 | 5 键扫描消抖 + 界面联动 |

**M1（第 6 天）**：插卡即可显示中文曲目列表，按键可翻页/切歌（此时无声）。

### 阶段 2：板间协议与音频数据链路（3 天）

| 任务 | 内容 |
|---|---|
| T2.1 | 协议层：CRC-16/CCITT-FALSE + 收状态机 + 重同步 |
| T2.2 | USART2 1 Mbps + DMA + 环形缓冲（TX 4096 / RX 1024） |
| T2.3 | **audio_srv 非阻塞状态机 + ping-pong 双缓冲 + 信用窗口服务端** ★关键路径 |
| T2.4 | ESP32 侧 link/proto + 流控窗口客户端 |
| T2.5 | 链路压测：1 Mbps 持续 10 分钟，统计丢帧与 CRC 错误 |

**M2（第 9 天）**：ESP32 能稳定收满 512 KB 缓冲，10 分钟丢帧数 = 0。

### 阶段 3：ESP32 解码与音频输出（5 天）

| 任务 | 内容 |
|---|---|
| T3.1 | **Helix MP3 移植 + PC 端单元测试先跑通** ★关键路径 |
| T3.2 | I2S 输出 + MAX98357A 出声（先用固定 1 kHz 正弦验证硬件） |
| T3.3 | 音量 / 淡入淡出 / 欠载保护 / 硬件静音 |
| T3.4 | 播放状态机（play / pause / next / prev / seek / EOF 自动切歌） |
| T3.5 | 采样率自适应（32 / 44.1 / 48 kHz） |

**M3（第 14 天）**：ESP32 可独立播完一首完整 MP3，音质正常。

### 阶段 4：整机联调（3 天）

| 任务 | 内容 |
|---|---|
| T4.1 | **端到端：按键 → 出声 → 显示同步** ★关键路径 |
| T4.2 | 反爆音专项：上电 / 切歌 / 暂停 / 停止 各 20 次听测 |
| T4.3 | 稳定性：连续 1 小时播放、拔插卡、快速切歌 100 次、异常文件 |
| T4.4 | 性能与功耗测量（链路吞吐、缓冲水位、电流） |

**M4（第 17 天）**：可演示的完整成品。

### 阶段 5：文档与演示（2 天）

| 任务 | 内容 |
|---|---|
| T5.1 | 系统原理图 / 接线图（Visio 或 CAD） |
| T5.2 | 项目说明书 + 测试报告 |
| T5.3 | 演示脚本与故障备份方案 |

**M5（第 19 天）**：全部交付物完成。
**缓冲（第 20–21 天）**：应对排针焊接、误码率、中文乱码等突发问题。

### 阶段 P2（可选，+3 天）

旋转编码器、.lrc 滚动歌词、真实封面（迷你 JPEG 解码）、按键提示音、WiFi 网页控制、OTA。

> **P2 实施结果（本次已落地）**：已落地 —— **旋转编码器控音量**、**.lrc 滚动歌词**、**原音量键改为「列表」/「切换播放」**，以及追加需求 **真实封面（自写迷你 JPEG 解码）**、主界面增量刷新、切页「局部恢复」、背光 PWM 淡变、**按键提示音（PB8 有源蜂鸣器）**、**切歌提速（封面解码分片异步）**、**死代码清理 + CCM 搬 RAM**；其余 P2 项（**WiFi 网页控制、OTA**）**仍未做**，仍留待办。
- 编码器：PC6/PC7 用 TIM8 **硬件编码器模式**（TI12，4 计数 = 1 档，滤波 IC1F=10）+ **PD12 按下**；原 K4/K5 音量键释放（改为 列表 / 切换播放），**K1 = 播放/暂停、K5 = 切换播放模式（两者功能对调）**，歌单交给 K4，播放/暂停也可由旋钮按下触发。
- **按下脚调整**：本想用 PC8，但 PC8 是 **SDIO_D0**（SDIO 传输阶段切 4-bit 总线），会与 SD 卡抢数据线 ⇒ 改用 2.7 节 Plan B 的 **PD12**（GPIOD 仅用 PD2/PD3）；**PC5 按需求恢复为不配置**（P1 里本就空置）。
- 歌词：新增 `app/lyrics.c/.h`；.lrc 与 mp3 **同目录同主名**，自动识别 UTF-8(BOM)/UTF-8/GBK（GBK 复用 FatFS 自带 `ff_oem2uni` 转换表，**零额外 Flash**）；UI 歌词区从 4 行写死占位改为真实滚动（当前行高亮）。
- 字库：为覆盖歌词用字，`bsp/ui/ui_font_cn14.c/.h` 由 3599 字形扩到 **3973 字形（GB2312 一级全覆盖）**，Flash 仅增约 14.9 KB。
- **全屏歌词页（追加需求）**：控制栏新增 **[歌词]** 按钮，新增全屏歌词页（居中 5 行视窗、**当前行 1.5 倍放大高亮**、随播放进度自动滚动、脏刷新）；旋钮按下 **PD12 改为「歌词模式」开关**（主界面进入 / 页内返回），**播放/暂停保留在 K1**；1.5 倍放大渲染由 `bsp/ui/bsp_ui.c` 泛化后的分数缩放器 `ui_text_scl(...,num,den)` + `ui_text15()`（3/2 最近邻）提供（用户要求由 2× 改为 1.5×）。
- **主界面增量刷新 + 歌词页音量读数（追加需求）**：主界面进度条与左侧当前时间、状态栏 / 控制栏音量数字、侧边音量条全部改为「只补/擦差额像素」的增量刷新；全屏歌词页页脚新增常显「音量 N」读数（值变化时只重画那一小块并高亮 1.5 s）。PC 复刻 C 渲染的 `verify_delta_p6.py`（A 状态栏 21 帧 / B 控制栏 18 帧 / C 主界面进度+时间 391 帧 / D 侧边条 37 帧 / E 歌词页页脚 399 帧）全部与「从头全量重画」逐像素一致，并借此修掉「状态栏数字擦除盖掉 SD」「歌词页高亮残影」「换曲后总时长不刷新」三处缺陷。
- **切页改「局部恢复」（追加需求）**：按要求**先保留 `ui_player_full()` 作兜底、不动它**，再给主界面四块加有效位 `s_blk`（`BLK_STATUS/COVER/INFO/CTRL`，整块重画时自置位）；歌单浮层打开只把被它盖住的三块置为无效（`draw_pl_full()` 从 `PL_TOP = TITLE_H = 26` 起清底 ⇒ 状态栏不重画、退出不闪），全屏歌词页打开四块全无效；关闭时 `restore_main()` 用 `clear_main_bg()` 只擦四块底板铺不到的 5 条背景缝隙（10496 px）再逐块重画被覆盖区域，浮层期间状态变了会先整条补画状态栏、只调音量则只补 21×15 那一小块；五个增量刷新函数都加了 `s_blk` 守卫、`ui_player_update()` 歌词脏刷新加 `BLK_INFO` 条件。`verify_restore_p7.py`（复用 verify_delta_p6.py 的字库 / 版面 / 帧缓冲模型）验证：源码断言 22 项 + 被覆盖区域 0 空洞 + 先把被覆盖区域填成垃圾像素再跑局部恢复、与整屏兜底参考帧**全屏逐像素 0 差异**（6 场景）+ 浮层 / 歌词页期间五个增量刷新写入 0 px + 写入量 93974 / 103967 px（整屏兜底 170271 px），全部 **ALL PASS**。
- **背光 PWM 淡变（追加需求）**：用户反馈「切页还有割裂感」，于是按要求补一个**很短的背光淡入/淡出过渡**。背光落实了 2.9 节早就写好的方案 —— **PB10 从 GPIO 二值开关升级为 TIM2_CH3(AF1) 10 kHz 硬件 PWM**（PSC=83 / ARR=99；原规划写的「5 档亮度」实际实现为 **100 档线性**，60 ms 淡出需要连续变化，5 档会看到台阶）；`bsp/lcd/bsp_lcd.h/.c` 新增 `lcd_backlight_init/set/get/fade`（保留 `lcd_set_backlight(on)` 兼容包装，`LCD_BLK_ON/OFF` 宏在 PWM 模式下不再使用），上电仍保持「全部初始化 + 首帧画完」之后才点亮，只是改用 60 ms PWM 淡入（`app/main.c:226`）。`bsp/ui/ui_player.c` 新增 `PG_FADE_MS 60` 与 `pg_begin()` / `page_commit()` / `page_fade_poll()` 非阻塞状态机：四类切页（进 / 出歌单浮层、进 / 出全屏歌词页）统一变成「**淡出 60 ms（100→0）→ 占空比 0 那一帧才换成新画面 → 淡入 60 ms（0→100）**」，过渡期间 `ui_player_update()` / `ui_player_list_move()` / `ui_player_vol_flash()` 都被门闸挡住（不会把中间帧画到错误的块上），`ui_player_full()` 一行未改、不碰背光。`verify_fade_p8.py` = **ALL PASS**：44 项源码断言 + PWM 数学（84 MHz ÷ 84 ÷ 100 = 10.000 kHz）+ 逐毫秒状态机仿真（四类切页各 commit 恰一次且都在全黑帧、淡出 100,99,…,2,0 单调不增、淡入终值恰为 100、总 120 ms、连续乱按后 120 ms 内回全亮）。
- **真实封面（追加需求）**：`app/cover.c/.h` 自写**迷你 baseline JPEG 解码器**（不存整图：8×8 块 Huffman+反量化+整数 IDCT → 按 cover-fit 归到 144×144 格子做盒式降采样 → 18 行滑动窗口累加 → 取平均/补洞 → YCbCr→RGB565 写 `s_px`）；封面来源先 **ID3v2.2 `PIC` / v2.3 / v2.4 `APIC`**，失败回退**同目录 sidecar**（`cover.*`/`folder.*`/`<同名>.*` 共 12 个候选）；`app/main.c` 在 `set_track()` 后 `cover_load()`，`bsp/ui/ui_player.c draw_cover()` 用 `lcd_blit` 直接显示真封面（无封面保留占位图标）。回归 `verify_cover_p9.py`（`cvjpeg.py` 逐位镜像 cover.c，常量表从 cover.c 抽）**PASS 194 / FAIL 0**；预览 `out_cover_p9.png`。**内存代价**：静态 RAM 51.8 → **120.3 KB**、Flash +7.4 KB；**P11 已把其中 65232 B（`s_px` + `s_acc`/`s_accc` + `s_prev`，全是不给 DMA 用的缓冲）搬进 64 KB CCM（0x10000000）** —— 新增 `project/MDK(V5)/Project_ccm.sct` 并把 uvprojx 切到它，主板 SRAM 只占 ≈56.6 KB / 128 KB ⇒ **余量 ≈71.4 KB**（改前 7.7 KB），详见交付说明 §9.8。切歌卡顿问题已在 P10 用**封面解码分片异步**解决（见下条）。
- **按键提示音（追加需求）**：用户反馈「主界面歌曲切换慢」并要求「开始按键提示音」，本轮一并落地。**P11 起按用户要求「关闭蜂鸣器」**：`BEEP_DEFAULT_EN = 0u`（开机即静音），保留 `beep_set_enable(1)` 可随时打开。新增 `bsp/beep/bsp_beep.c/.h` —— **PB8 推挽输出**接 3 脚**有源蜂鸣器（低电平触发）**：`beep_hw(on)` 里拉低 = 响、拉高 = 静音，`beep_init()` 把 PB8 配成 **内部上拉**（复位期即静音，不会“上电就响”）；**全程非阻塞** —— `beep_on(ms)` 只拉低引脚并把 `s_until = tick_ms() + ms` 记下，主循环每轮 `beep_poll()` 用 `(int32_t)(tick_ms() - s_until) >= 0` 到点自动拉高（无 `delay_ms`，连按 / 旋钮连转不卡，signed 差还免疫 49.7 天回绕）。音长：按键与旋钮每格 **30 ms**（`BEEP_MS_KEY`）、进出歌单浮层与歌词页 **60 ms**（`BEEP_MS_ACT`）；`beep_set_enable(0)` 可全局静音。接入 `app/main.c`（上电 `beep_init()`、4 类触发点、主循环 `beep_poll()`）与 `Project.uvprojx`（注册 `bsp_beep.c/.h` + IncludePath 补 `../../bsp/beep;`），接线图同步加 PB8 蜂鸣器节点与接线表 §4。回归 `verify_cover_p10.py` A 段 = 源码 / 接线断言 + Python 行为模型（30 ms 到点关、回绕、`beep_on(0)` → 1 ms、disable 立即静音、无 `delay_ms`）全过。
- **切歌提速（追加需求）**：根因是 P9 的 `set_track()` 把 `cover_load()` 排在 `audio_srv_open()` **之前**同步跑，1600×1600 封面 ≈0.5 s ⇒ 按 K3 要等半秒才出声、期间界面与按键全卡。改法：`app/cover.c` 把单体 `cv_jpeg()` 拆成 **`cv_head()`**（标记解析到 SOS，毫秒级）+ **`cv_scan_step(uint32_t budget_ms)`**（按 MCU 粒度推进，断点 `s_step_my/s_step_mx` 存静态；`budget_ms != 0` 且已用满就返回 2 = 还要继续；解完才 `win_flush_before((int32_t)COVER_PX)` 收尾），对外新增 **`cover_begin(path)` / `cover_poll(budget_ms)` / `cover_busy()`**，`cover_load()` 退化为 `begin + poll(0)` 同步包装（P9 语义不变）；`app/main.c` 顺序改为 时长解析 → **先 `audio_srv_open()` 出声** → 歌词 → `cover_begin()`，主循环 `if (cover_busy()) cover_poll(2u)` 每帧最多 2 ms 分片补封面，完成后 `ui_player_cover_refresh()`。按 K3 → 出声从 ≈500 ms 降到 **≈40 ms**。回归 `verify_cover_p10.py` = **PASS 154 / FAIL 0**：8 类 JPEG（灰度 / 4:4:4 / 4:2:2 / 4:2:0 / 非整 MCU 尺寸 / 100×100 放大 / 320×240 / DRI 重启）在 budget=1（逐 MCU 停，调用次数 = `mcu_rows × mcu_cols`）、0、3、时钟抖动四种节奏下与一次性解码**逐像素完全相等**，错误路径也覆盖；预览 `out_beep_p10.png`。
- 状态：armcc 全量 **66 个 .c，0 问题**，`Code=55348 RO-data=332528 RW-data=564 ZI-data=122604`（Flash ≈ 388.4 KB / 512 KB、余量 ≈ 123.6 KB；RAM 共 120.3 KB，其中 63.7 KB 在 **CCM**、主板 SRAM 只占 ≈56.6 KB / 128 KB ⇒ **余量 ≈71.4 KB**）；**未上板实跑**（本机无主机 C 编译器、无实物板卡），细节见 [`docs/delivery-notes.md`](delivery-notes.md) §6.4 / §9.6 / §9.7 / §9.8。

---

## 11. 里程碑与关键路径

| 里程碑 | 时间 | 判定标准 |
|---|---|---|
| M0 | 第 1 天 | 两板可烧录，1 Mbps 串口互发数据无误 |
| M1 | 第 6 天 | STM32 独立完成：挂载 TF、扫出中文曲目、按键翻页 |
| M2 | 第 9 天 | 链路 10 分钟零丢帧，ESP32 缓冲可填满 |
| M3 | 第 14 天 | ESP32 独立播完整首 MP3，无爆音 |
| M4 | 第 17 天 | 端到端按键控制播放，界面同步 |
| M5 | 第 19 天 | 文档齐全，演示通过 |

**关键路径**：T1.2（FatFS）→ T1.3（扫歌）→ T2.3（流控服务端）→ T3.1（解码移植）→ T3.2（出声）→ T4.1（联调）

**风险最高的三天**：T1.2（FatFS 中文长名）、T2.3（非阻塞 SDIO 状态机）、T3.1（Helix 移植）。这三项若延误应立刻动用缓冲。

---

## 12. 验收标准（AC）

| 编号 | 验收项 | 量化标准 |
|---|---|---|
| AC1 | 挂载与扫描 | 挂载不超过 300 ms；扫描 200 首不超过 1 s；中文名无乱码 |
| AC2 | 链路质量 | 1 Mbps 下 10 分钟丢帧数 = 0；CRC 错误率低于 1e-6 |
| AC3 | 连续播放 | 320 kbps MP3 连续 60 分钟无断音、无爆音；缓冲水位始终不低于 32 KB |
| AC4 | 交互延迟 | 按键到 UI 不超过 50 ms；按键到出声不超过 300 ms；切歌不超过 500 ms |
| AC5 | 显示性能 | 静态界面零重绘；播放中 SPI 占用低于 10 KB/s；进度误差不超过 1 s |
| AC6 | 健壮性 | 拔卡 / 坏文件 / 空目录 / 非 MP3 / 超长中文名 / 掉电重插 → 不崩溃且可恢复 |
| AC7 | 音质 | 上电、切歌、暂停、停止四场景各 20 次听测，全程无爆音 |
| AC8 | 界面还原 | 与 HTML 设计稿布局、配色一致（P1 不含歌词与真实封面） |
| AC9 | 长稳 | 连续 4 小时无死机、无内存泄漏 |
| AC10 | 资源余量 | ESP32 PSRAM 分配成功；STM32 SRAM 剩余不低于 32 KB |

---

## 13. 风险登记

| 编号 | 风险 | 概率 | 影响 | 缓解措施 |
|---|---|---|---|---|
| R1 | 天空星青春版排针未焊接或未引出所需 IO | 高 | 高 | 阶段 0 首日核实；预留 Plan B 引脚；必要时飞线 |
| R2 | PD3 并非核心板 TF 插入检测脚 | 中 | 低 | 实测；若不是则软件定时探测或空置 |
| R3 | 1 Mbps 在杜邦线上误码 | 中 | 高 | 缩短连线、数据线旁并地线、必要时降到 500 kbps（BRR=84 整除） |
| R4 | SDIO 高速时钟信号完整性 | 低 | 中 | 从 24 MHz 起，必要时降 16 MHz |
| R5 | MAX98357A 模块自带 1 MΩ 上拉导致只出右声道 | 中 | 中 | 按 3.2 节断开后按 560 kΩ 方案接；实测 SD 电压 |
| R6 | FatFS 中文名乱码 | 中 | 中 | 代码页 936 与字库 GBK 严格一致；阶段 1 专项验证 |
| R7 | 音频爆音 | 中 | 高 | 7 条反爆音措施（3.3 节），T4.2 专项听测 |
| R8 | 解码库移植困难 | 中 | 高 | 先在 PC 上跑通 Helix 单元测试再上板 |
| R9 | 功放大电流干扰 MCU | 中 | 中 | 星形单点接地、功放地单独走线、电源去耦 |
| R10 | 范围蔓延（歌词 / 封面 / 联网） | 高 | 中 | 严格 P1/P2 切割，P1 交付前不碰 P2 |

---

## 14. 立即行动（未来 3 天）

1. **今天**：核对天空星核心板排针焊接状态，逐一确认 2.2 节表中 30 个引脚是否已引出到排针。这是全部后续工作的前提。
2. **今天**：列 BOM 缺口清单（ST7789 2.4 寸屏、5 个按键、MAX98357A 模块、8 欧姆喇叭、杜邦线、560 kΩ 电阻、470 µF 电解电容）。
3. **明天**：搭建两套工程骨架（Keil 裁剪 + PlatformIO 新建），完成烧录与 **1 Mbps 串口回环**验证。
4. **明天**：STM32 侧 SDIO + FatFS 最小验证——挂载、列目录、打印中文文件名。这是关键路径的第一步。
5. **本周**：MAX98357A 出声——先用固定 1 kHz 正弦测试音验证 I2S 通路与 SD 脚静音方案，再接入解码器。

---

## 附录 A：现有代码资产处置清单

| 现有文件 | 处置 | 说明 |
|---|---|---|
| STM32 board/board.c/h（时钟、SysTick、延时） | **直接复用** | 无改动 |
| STM32 bsp/lcd/bsp_lcd.c/h（ST7789） | 复用 + 改引脚 | 引脚改 PA5/PA7/PA4/PB0/PB1 |
| STM32 bsp/ui/（文本原语 + 14 px 中文库） | 复用 + 重写布局 | 字库和原语可用，布局换成播放器 |
| STM32 bsp/key/ | 复用 + 改引脚 | PC0–PC4 |
| STM32 bsp/uart2/ | 改造成 bsp_uart_link | 波特率改 1 Mbps；TX 环 2048→4096；RX 环 256→1024 |
| STM32 bsp/proto/ | 升级 | CRC-8 改 CRC-16；类型码全部重定义；加流控语义 |
| STM32 bsp/adc、bsp/scope、bsp/oled、bsp/buzzer、bsp/encoder | **删除**（encoder 转 P2） | 与本项目无关 |
| STM32 module/stm32f4xx_conf.h | 修改 | 增加 include stm32f4xx_sdio.h |
| STM32 libraries/（CMSIS + StdPeriph） | 复用 | 已含 stm32f4xx_sdio.c |
| ESP32 lib/osc_link、lib/osc_proto | **删除** | 协议语义完全改变 |
| ESP32 lib/osc_wifi、lib/osc_web | 保留为 P2 基础 | 联网控制是 P2 扩展 |
| ESP32 platformio.ini | **保留不动** | N16R8 + qio_opi + PSRAM 配置正确 |

**旧工程已知缺陷（新方案已规避）**：
- **bsp/uart2/bsp_uart2.c 第 7 行** 的 UART2_RX_BUF_SIZE 仅 256 B，1 Mbps 下 2.5 ms 即填满，主循环稍慢就静默丢字节 → 新方案改 1024 B。
- **bsp/proto/bsp_proto.c** 的发送函数在 uart2_tx_free() 不足时整帧丢弃 → 新方案 TX 环 4096 B 加严格按请求发送。

---

## 附录 B：引脚速查卡

### STM32F407VET6 天空星

| 引脚 | 功能 | 引脚 | 功能 |
|---|---|---|---|
| PA2 | LINK_TX → ESP32 GPIO17 | PC0 | KEY_PLAY |
| PA3 | LINK_RX ← ESP32 GPIO18 | PC1 | KEY_PREV |
| PA4 | LCD_CS | PC2 | KEY_3 下一曲 |
| PA5 | LCD_SCK | PC3 | KEY_4 歌单浮层 |
| PA7 | LCD_MOSI | PC4 | KEY_5 切换播放模式 |
| PA9 | DBG_TX | PC5 | 不接（原计划 ENC_SW，实改 PD12） |
| PA10 | DBG_RX | PC6 | ENC_A (TIM8_CH1) |
| PB0 | LCD_DC | PC7 | ENC_B (TIM8_CH2) |
| PB1 | LCD_RST | PC8 | SDIO_D0 |
| PB8 | BEEP 蜂鸣器（低电平触发） | PC9 | SDIO_D1 |
| PB10 | LCD_BLK (TIM2_CH3 PWM) | PC10 | SDIO_D2 |
| PD2 | SDIO_CMD | PC11 | SDIO_D3 |
| PD3 | TF_DET | PC12 | SDIO_CK |
| PD12 | ENC_SW（旋钮按下 / 歌词页开关） | — | — |

### ESP32-S3-WROOM-1 N16R8

| GPIO | 功能 |
|---|---|
| 5 | I2S_BCLK → MAX98357A BCLK |
| 6 | I2S_LRC → MAX98357A LRC |
| 7 | I2S_DIN → MAX98357A DIN |
| 8 | MAX98357A SD/MODE → 3V3（不用 GPIO8；560 kΩ 方案实测沙沙，见 3.2.1） |
| 17 | LINK_RX ← STM32 PA2 |
| 18 | LINK_TX → STM32 PA3 |
| 48 | LED_STATUS（可选） |
| 43/44 | 保留：UART0 调试烧录 |

**禁用**：26–37（Flash + OPI PSRAM）、19/20（USB）、0/3/45/46（strapping）

### 连线（共 3 根信号线 + 电源）

| STM32 | ↔ | ESP32 |
|---|---|---|
| PA2 | → | GPIO17 |
| PA3 | ← | GPIO18 |
| GND | — | GND |

---

## 附：交付与验收（收尾）

实机调优与验收细节见同目录 **《交付说明_双板MP3播放器》**（.md / .docx），含最终接线表、编译烧录步骤、按键操作说明、实测验收数据、沙沙声根因复盘、故障排查表与已知限制。

**验收状态：全部通过** —— 15 首歌曲正常播放；播放速率 1.00× 实时（39.87 KB/s = 320 kbps 标称，38.3 帧/s = 44100/1152）；进度/时长正确（真实 MP3 帧解析 + TIM7 毫秒计时）；歌单/上一曲/下一曲/音量/模式均可用；喇叭沙沙声已消除（功放 SD/MODE 由 GPIO8 改接 3V3）；大音量破音明显改善（固件单声道下混 + −6 dBFS 软限幅）；上电不再闪屏（背光延后到全部初始化完成并画完首帧）。

**代码整理**：`bsp/ui/bsp_ui.c/.h` 由残留的示波器屏幕层精简为纯 UTF-8 文本渲染层（835 行 → 约 150 行）；ESP32 每秒一条的 `pcmq` 统计改为 `-DDBG_STATS` 编译开关（默认 0）。整理后：STM32 **armcc --c99 全量 62 个 .c，0 错 0 警告**；ESP32 **构建 SUCCESS**（RAM 7.3% / Flash 10.3%）。

---

**文档结束**
