h-xh-git/STM32-ESP32-MP3-Player/hardware/wiring-diagram.html

# 双板 MP3 播放器 · 引脚接线图 v1.0 · 与固件代码一致

STM32F407VET6 天空星（存储 / 界面 / 按键）＋ ESP32-S3 N16R8（MP3 软解 / I2S 输出）＋ MAX98357A（D 类功放）→ 8Ω 喇叭

接线前必读（4 条）

- 共地：STM32、ESP32、MAX98357A、5V 电源的 GND 必须全部连在一起，否则串口乱码、音频全是噪声。
- MAX98357A 用 5V 独立供电（≥1A），不要用 3.3V；它与两块板的信号线是 3.3V 电平，可以直连。
- 喇叭接 OUT+ / OUT− 差分，OUT− 绝对不能接 GND，也不能把喇叭任一端接地。
- ESP32 可用 IO：避开 GPIO26–32（OPI PSRAM 占用）、GPIO19/20（原生 USB）、GPIO43/44（UART0 日志/烧录）、GPIO0/3/45/46（strapping）。本方案用的 GPIO5/6/7/8/17/18/48 全部安全。

## 1 · 系统连线框图

## 2 · STM32 天空星 → TFT（ST7789 2.4" SPI 屏）

TFT 丝印 | STM32 引脚 | 说明
VCC | 3.3V | 逻辑供电（模块自带 3.3V 稳压时也可接 5V，按你的模块丝印）
GND | GND | 共地
SCK / CLK | PA5 | SPI1_SCK
SDA / MOSI | PA7 | SPI1_MOSI（只写，无 MISO）
CS | PA4 | 片选（软件控制）
DC / RS | PB0 | 数据 / 命令选择
RES / RST | PB1 | 硬件复位
BLK / LED | PB10 | 背光控制（高=亮）。固件时序：上电 -> 面板初始化 + 整屏填黑 -> 外设/文件系统/UI 初始化 -> 画好首帧 -> 最后才拉高开背光，因此上电过程屏幕全黑、不会闪屏或露花屏。 硬件建议：在 BLK 与 GND 之间加一个 10 kΩ 下拉——MCU 复位期间 PB10 是高阻，有下拉才能保证复位/上电瞬间背光一定是灭的（不加的话模块内部若有上拉，上电可能会亮一下）。
TP_* / SDO | 不接 | 触摸屏与 MISO 未使用

## 3 · 独立按键与旋转编码器（内部上拉，按下接地）

按键 | STM32 引脚 | 固件功能
K1 | PC0 | 播放 / 暂停（全屏歌词页内仍是播放 / 暂停）
K2 | PC1 | 上一曲（歌单内：上移）
K3 | PC2 | 下一曲（歌单内：下移）
K4 | PC3 | 短按：歌单（开 / 关歌单浮层）
K5 | PC4 | 短按：切换播放模式（顺序 / 单曲 / 随机；歌单内 K4/K5 均为返回 / 关闭）
旋钮 A 相 | PC6 | TIM8_CH1（AF3），硬件编码器模式
旋钮 B 相 | PC7 | TIM8_CH2（AF3）
旋钮按下 SW | PD12 | 按下接地；功能：歌词模式（主界面 = 进入全屏歌词页，歌词页内 = 返回主界面；播放 / 暂停改由 K1 负责）

接法：每个按键 / 旋钮触点一端接对应引脚，另一端接 GND；内部上拉已开，无需外接电阻。旋转编码器每格 4 个计数（ENC_COUNTS_PER_DETENT），旋转 = 音量 ±5，旋钮按下 = 歌词模式开关（播放 / 暂停改为 K1）。
注意：PC5 不接（P1 起就空置）、PC8 不可占用——PC8 是 SDIO_D0，接旋钮按下会和 TF 卡抢数据线，所以按下脚用 PD12。

## 4 · 按键提示音：有源蜂鸣器（PB8，低电平触发）

蜂鸣器模块 | STM32 引脚 | 说明
VCC | 3.3V | 3 脚有源蜂鸣器模块（VCC / GND / IO），内部自带振荡电路，只占一个 GPIO，不占用任何定时器 / PWM 通道
GND | GND | 共地
IO / S / 信号 | PB8 | 低电平触发：PB8 拉低 = 响，拉高 = 静音。固件把 PB8 配成 推挽输出 + 内部上拉，复位 / 浮空期间被上拉钳在高电平，上电不会先“嘀”一声；beep_set_enable(0) 可全局静音。 固件时序：按键 / 旋钮格数 → 30 ms（BEEP_MS_KEY），进出歌单浮层 / 歌词页 → 60 ms（BEEP_MS_ACT）；beep_poll() 在主循环里到点自动关，全程非阻塞、不 delay。

为什么用有源模块：有源蜂鸣器内部自带振荡电路，MCU 只要给一个直流电平就能响；无源蜂鸣器需要 MCU 输出方波载波（要额外占一个定时器通道 + PWM），本项目用有源模块，所以 PB8 只做普通推挽输出即可。
引脚不冲突：TFT 用 PB0 / PB1 / PB10，按键 / 旋钮用 PC0-PC4 / PC6 / PC7 / PD12，SDIO 用 PC8-PC12 / PD2 / PD3，USART2 用 PA2 / PA3，PB8 单独留给提示音。

## 5 · TF 卡（板载卡座，SDIO 4 位模式）

SD 信号 | STM32 引脚 | 说明
D0 / DAT0 | PC8 | SDIO_D0
D1 / DAT1 | PC9 | SDIO_D1
D2 / DAT2 | PC10 | SDIO_D2
D3 / DAT3 | PC11 | SDIO_D3
CLK | PC12 | SDIO_CK（识别 400kHz，传输 12MHz）
CMD | PD2 | SDIO_CMD
卡检测 CD | PD3 | 低电平 = 卡在位

天空星底板板载卡座已按上表硬连线，通常无需飞线；仅在底板未引出这些引脚时才需要外接卡座。卡请格式化为 FAT32，歌曲放根目录或 /MUSIC 下。

## 6 · STM32 ↔ ESP32-S3 串口互联（交叉接线）

STM32（USART2） | 方向 | ESP32-S3（Serial1） | 说明
PA2 (TX) | → | GPIO17 (RX) | STM32 发给 ESP32 的帧（音频数据 + 状态）
PA3 (RX) | ← | GPIO18 (TX) | ESP32 发给 STM32 的帧（控制 + 音频请求）
GND | — | GND | 必须共地

参数：1 000 000 bps，8 数据位 / 无校验 / 1 停止位（不要设 460800，带宽不够会爆音）。两边都是 3.3V 电平，直连，不要串 5V。

## 7 · ESP32-S3 → MAX98357A → 喇叭

MAX98357A | ESP32-S3 | 说明
BCLK | GPIO5 | I2S 位时钟
LRC / LRCLK / WS | GPIO6 | I2S 左右声道时钟
DIN | GPIO7 | I2S 数据（MAX98357A 无需 MCLK）
SD / MODE | 接 3V3 | 注意：这不是单纯的使能脚，它同时选声道。电压 <0.16V = 关断；0.16~0.77V = 输出 (L+R)/2；0.77~1.4V = 只出右声道；>1.4V = 只出左声道。引脚内部自带 100kΩ 下拉，所以想落在中间档必须外加对 Vin 的上拉电阻。 最终接法：SD 直接接 3V3（>1.4V，只出左声道）。固件已把立体声下混成单声道并复制到左右两槽，因此不丢右声道内容。 实测：用 GPIO8 经 560kΩ 驱动 SD 时喇叭全程沙沙——该节点是高阻分压点，电平不稳会让功放在声道模式间来回跳；硬接 3V3 后干净。
VIN | 5V | 独立 5V ≥1A（功放瞬时电流大）
GND | GND | 共地
GAIN | 不接 | 实测本机悬空 = 9dB，也是当前推荐接法。若大音量仍破音，想再多 6dB 余量就把它改成 3dB 档：GAIN 经 100kΩ 接 Vin（注意：把 GAIN 直接接 GND 是 12dB，会更响更破，别接错）。悬空 = 9dB（官方增益表，改动后需重新上电：15dB = GAIN 经 100kΩ 接 GND；12dB = GAIN 直接接 GND；9dB = GAIN 悬空（本机实测采用）；6dB = GAIN 直接接 Vin；3dB = GAIN 经 100kΩ 接 Vin（余量最大档））
OUT+ / OUT− | 喇叭 + / − | 差分输出，OUT− 不得接地

## 8 · 调试串口（USART1，看 printf 日志）

STM32 | 方向 | USB-TTL 模块
PA9 (TX) | → | RXD
PA10 (RX) | ← | TXD
GND | — | GND

波特率 115200。注意：printf 走的是板上的 2×5P 调试排针，不是 Type-C 口（Type-C 只给 ST-Link/串口下载用）。

## 9 · 通电顺序建议

步骤 | 接线 | 验证点
1 | STM32 + TFT + 按键 + TF 卡 | 屏幕出现播放器界面、歌单能打开、歌名/大小/时长正确
2 | 再加 STM32 ↔ ESP32 串口（先不接功放） | ESP32 串口能看到 STM32 的帧，STM32 心跳日志 drops=0
3 | 再加 MAX98357A + 喇叭 | 按 K1 出声（旋钮按下现在进入全屏歌词页），位置进度条随播放前进

双板 MP3 播放器 · 引脚接线图 v1.0 · 引脚与 bsp/lcd、bsp/key、bsp/sdio、bsp/uart2、bsp/uart 源码一一对应。
