h-xh-git/STM32-ESP32-MP3-Player/(notices)

Notices in the files:
README.md:
License: MIT
